selinux/2d-thermography/README.md

2d-thermography
===============

Aquire points or render a 2d-thermography image  using a MLX90614 IR thermometer

This project is mainly going to be a proof of concept :

The main purpose is to control smoothly the hardware and aquire
points as fast as possible throw a serial line. Image rendering
will be done by octave.

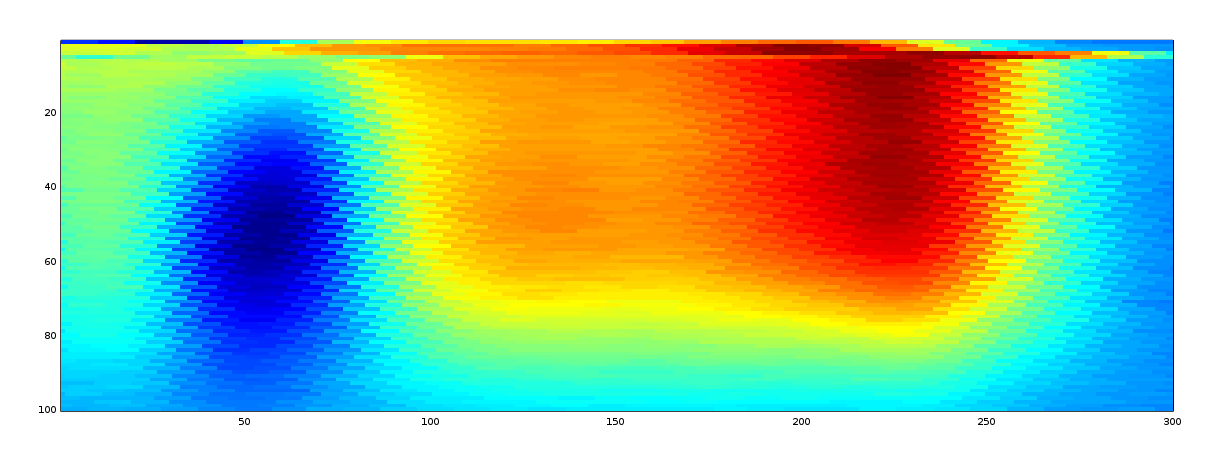
[picture p1: media/source_mesure.png]


    scan duration 10min
 * [video exemple 1...](http://youtu.be/MxMDqLkLDO0)\\
 * [video exemple 2...](http://youtu.be/shVt-1LP7H4)

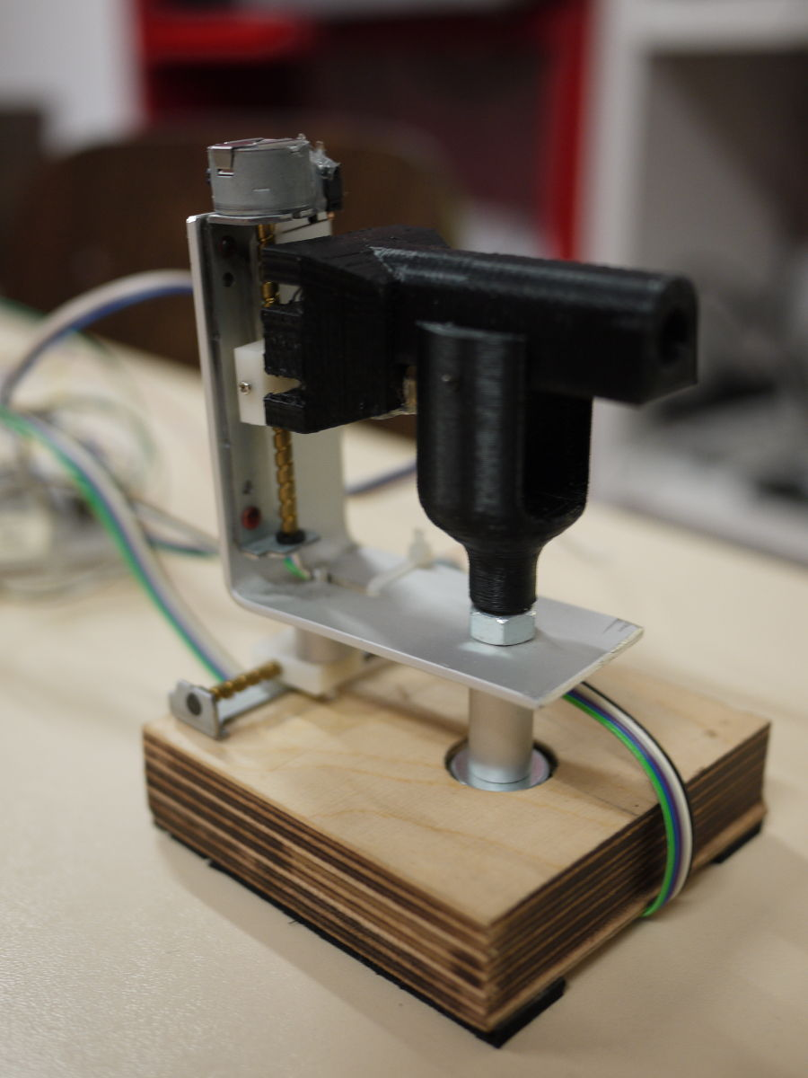
[picture p2: media/2d-thermography-harware_4.jpg]


hardware :
--

    - arduino
    - 2 cd stepper
    - MLX90614ESF-DCI  3V (also available in 5V)
    - a laser pointer
    - ITEAD Dual Step Motor Driver Shield
        (I tryed with Pololu but motors VDD must be > 8V
         to work and cd motor's I use support only 4-6V )
    - 2 mechanic endstop

BOM :
--

* http://shop.boxtec.ch/infrared-thermometer-sensor-medical-mlx90614esf-dci-p-40658.html
* http://www.aliexpress.com/snapshot/6167745304.html
* http://www.aliexpress.com/snapshot/6124275888.html
* http://imall.iteadstudio.com/im120417015.html
