selinux/2d-thermography/docs/links-references.txt

http://bildr.org/2011/02/mlx90614-arduino/

http://wiki.iteadstudio.com/Arduino_Dual_Step_Motor_Driver_Shield
