selinux/2d-thermography/media/2d-thermography-front.jpg

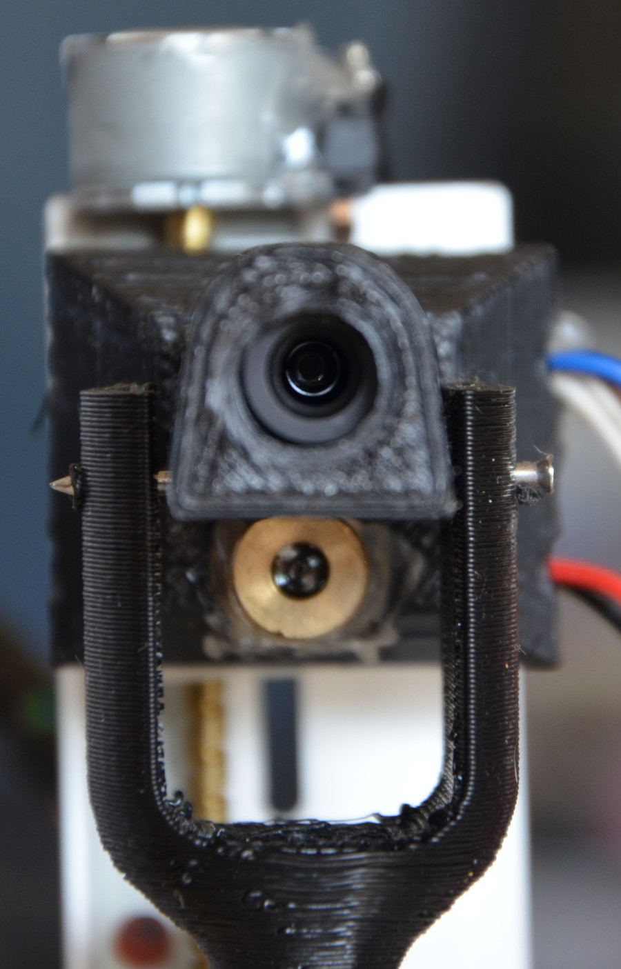
media/2d-thermography-front.jpg
