selinux/2d-thermography/media/2d-thermography-harware_0.jpg

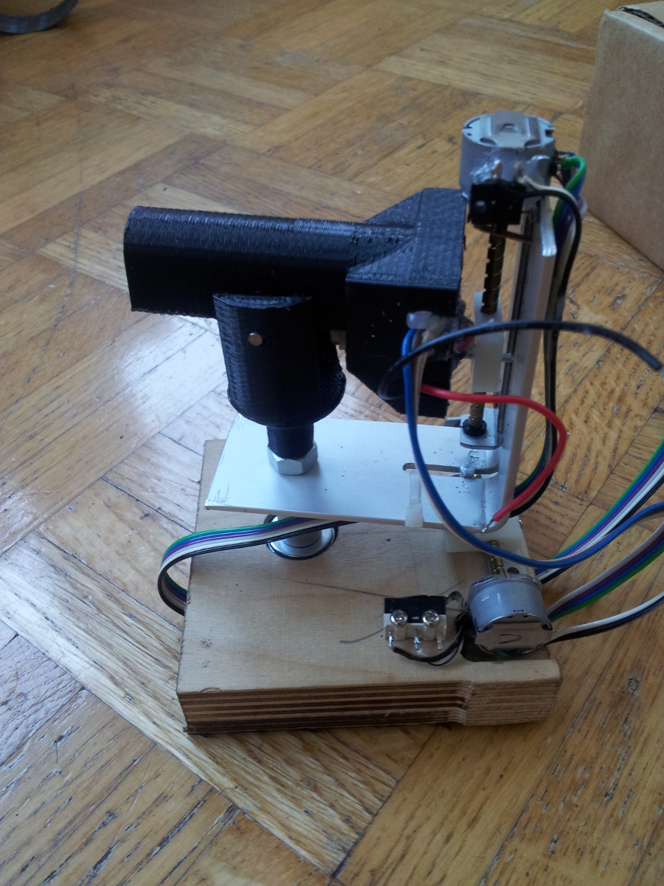
media/2d-thermography-harware_0.jpg
