selinux/2d-thermography/media/2d-thermography-harware_1.jpg

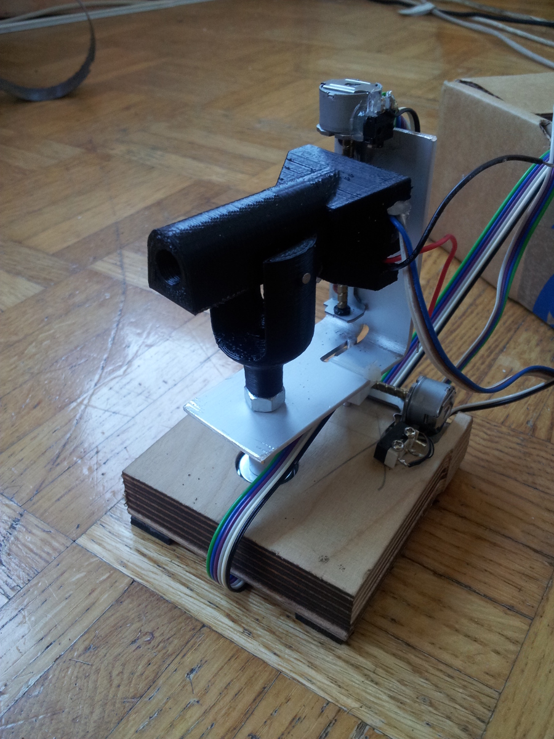
media/2d-thermography-harware_1.jpg
