selinux/2d-thermography/media/2d-thermography-harware_2.jpg

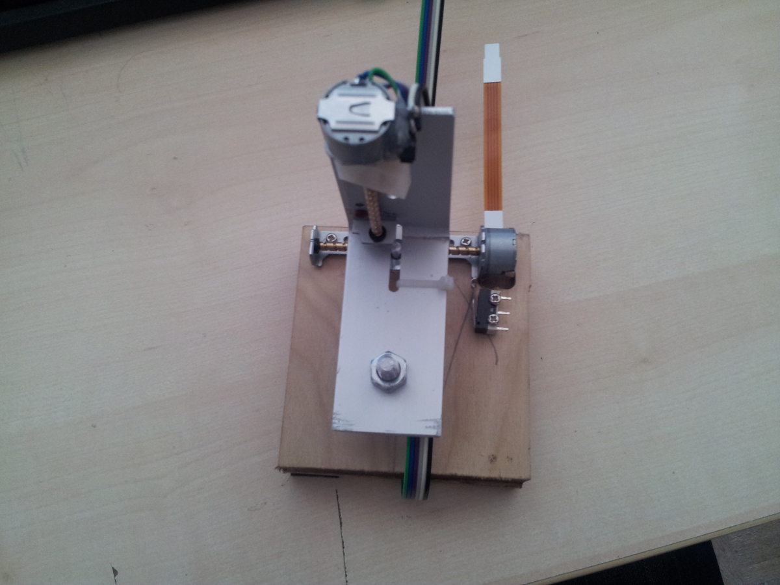
media/2d-thermography-harware_2.jpg
