selinux/2d-thermography/media/2d-thermography-harware_3.jpg

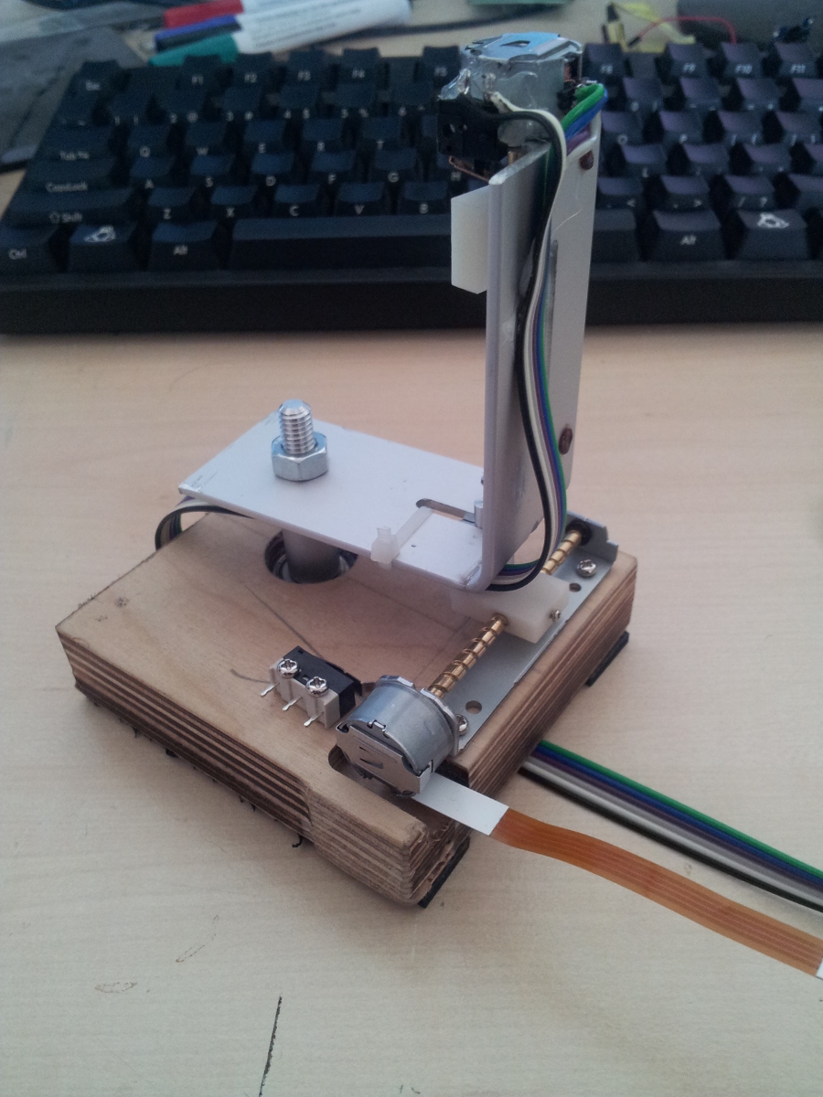
media/2d-thermography-harware_3.jpg
