selinux/2d-thermography/media/2d-thermography-mid.jpg

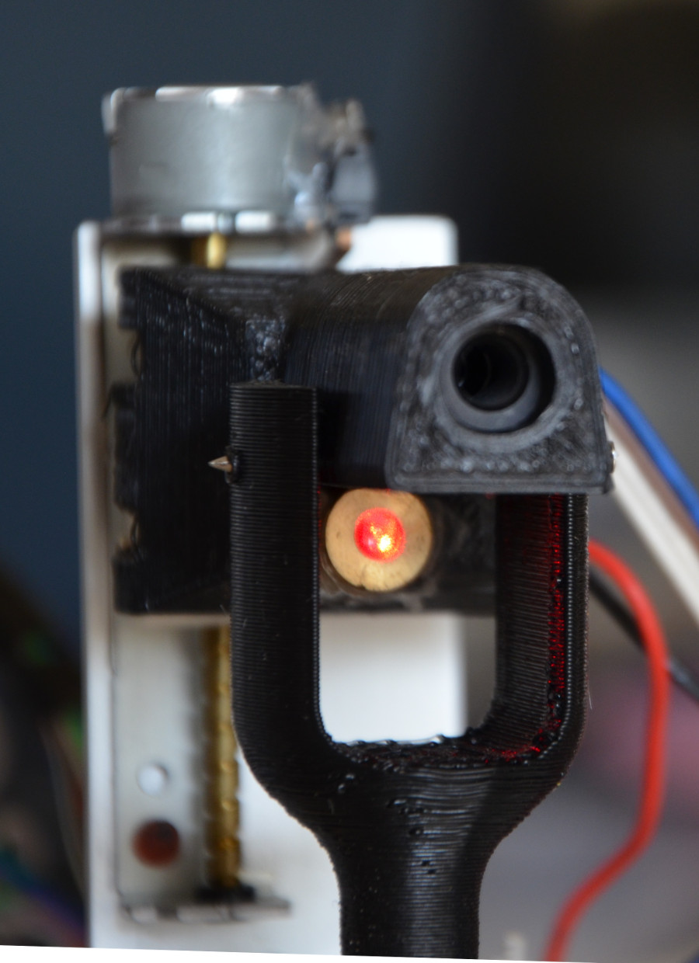
media/2d-thermography-mid.jpg
