selinux/2d-thermography/media/casserolle.png

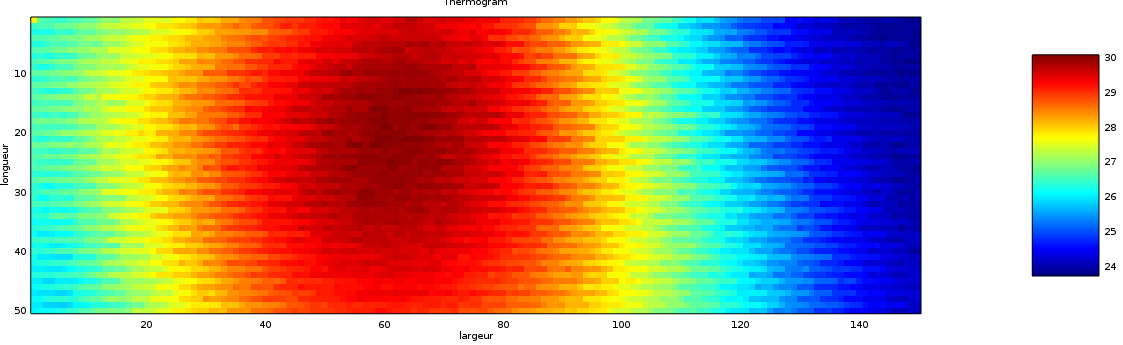
media/casserolle.png
