selinux/2d-thermography/media/casserolle_comp.png

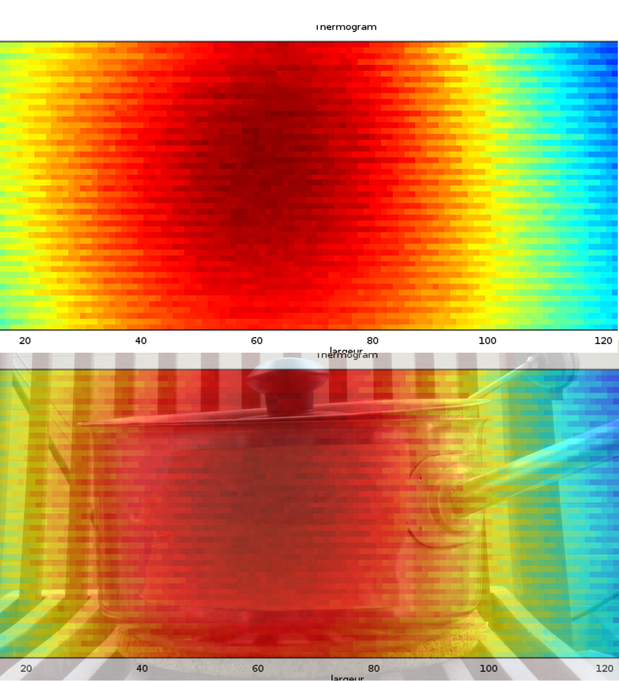
media/casserolle_comp.png
