selinux/2d-thermography/media/delay.png

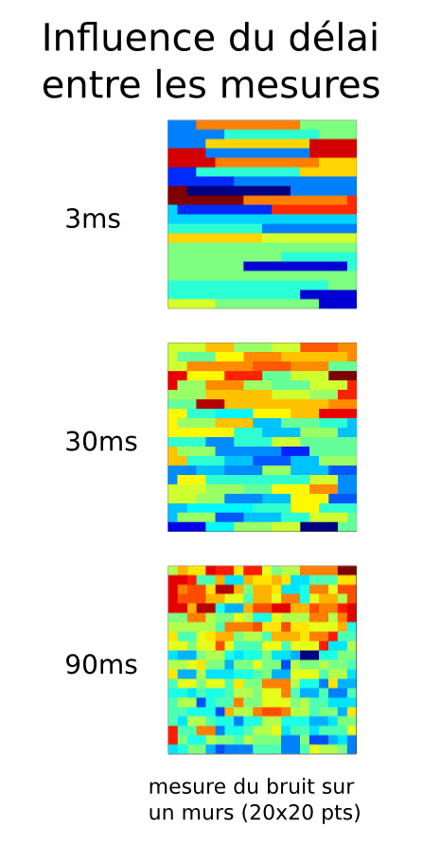
media/delay.png
