selinux/2d-thermography/media/me_site_on_a_chair_(hips).png

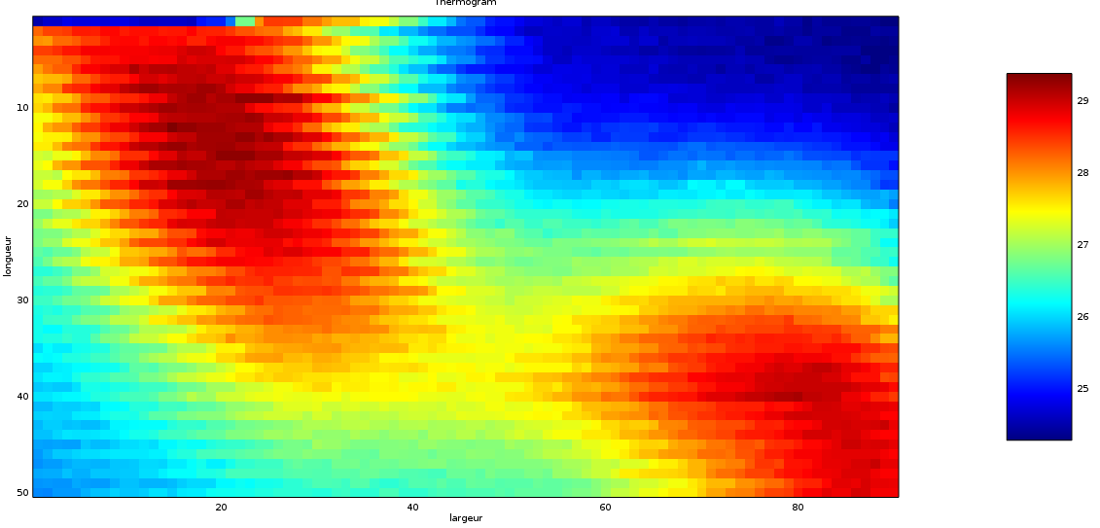
media/me_site_on_a_chair_(hips).png
