selinux/2d-thermography/media/sample-01.png

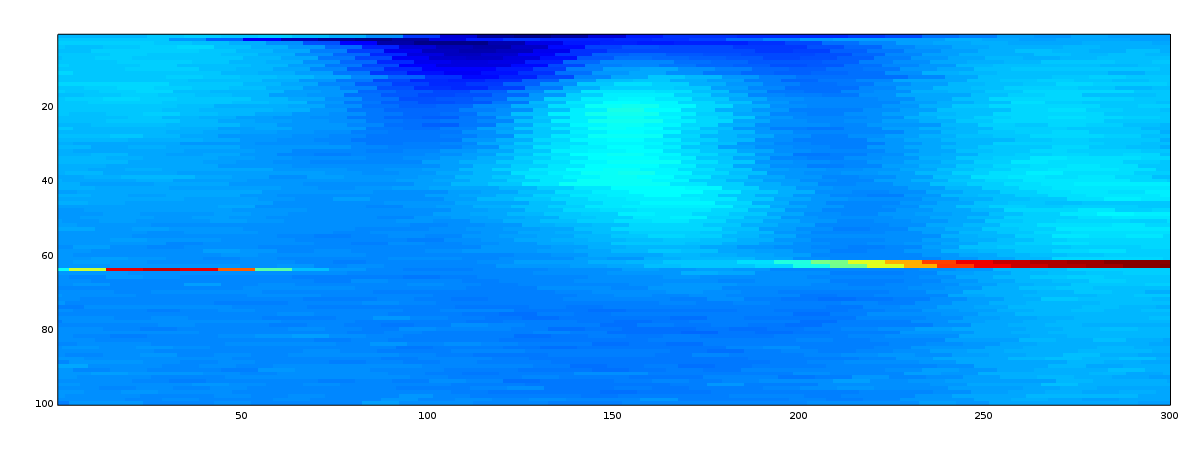
media/sample-01.png
