selinux/2d-thermography/media/sample-02.png

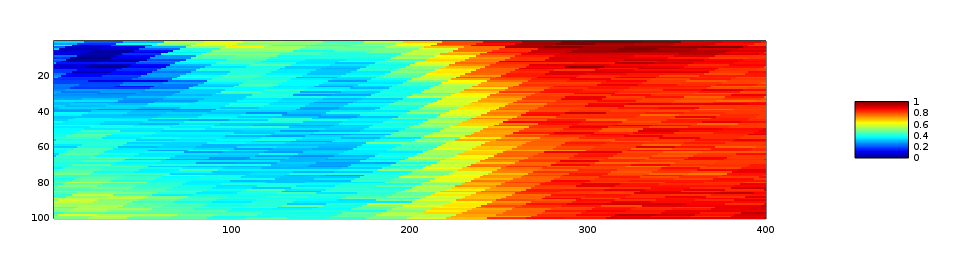
media/sample-02.png
