selinux/2d-thermography/media/sample-03.png

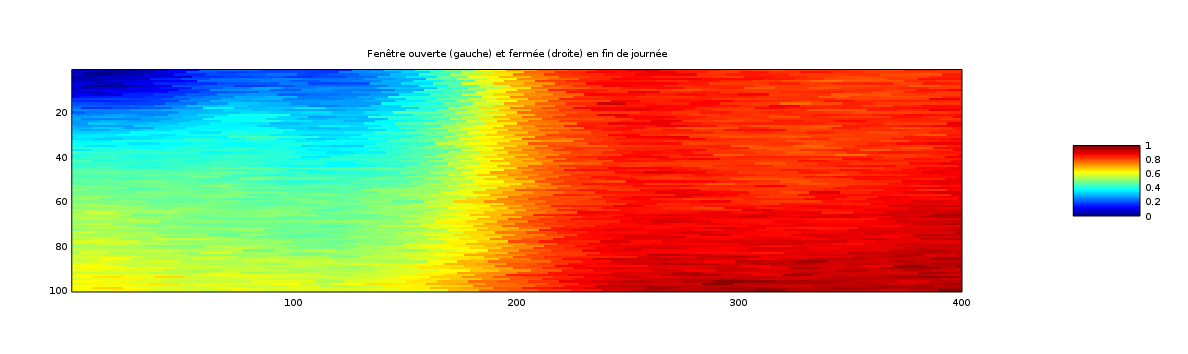
media/sample-03.png
