selinux/2d-thermography/media/sample-04.png

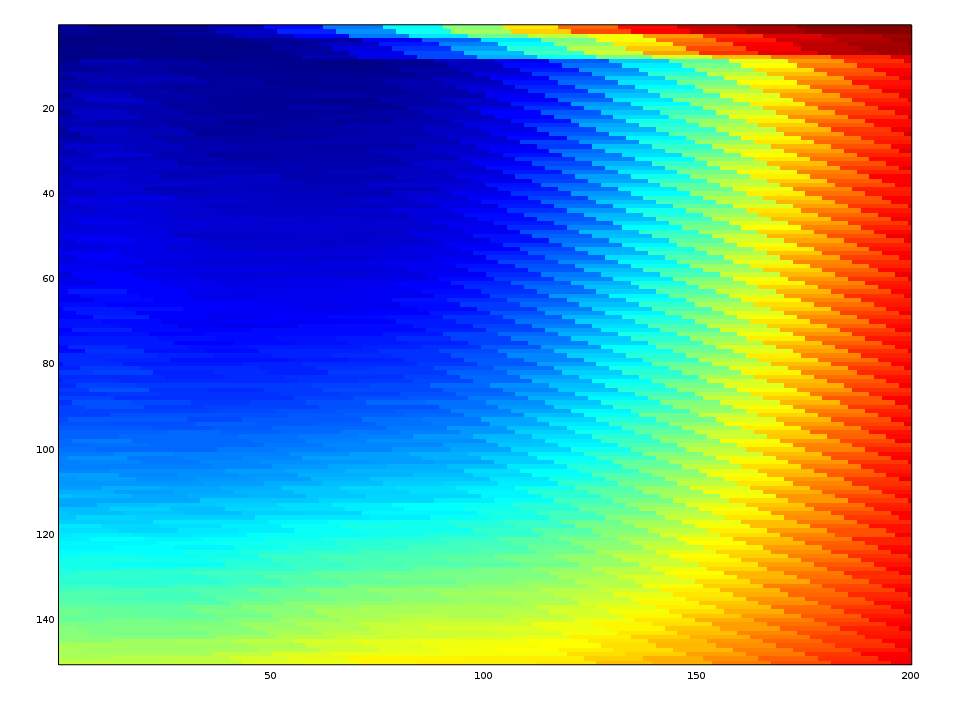
media/sample-04.png
