selinux/2d-thermography/media/sample-05.png

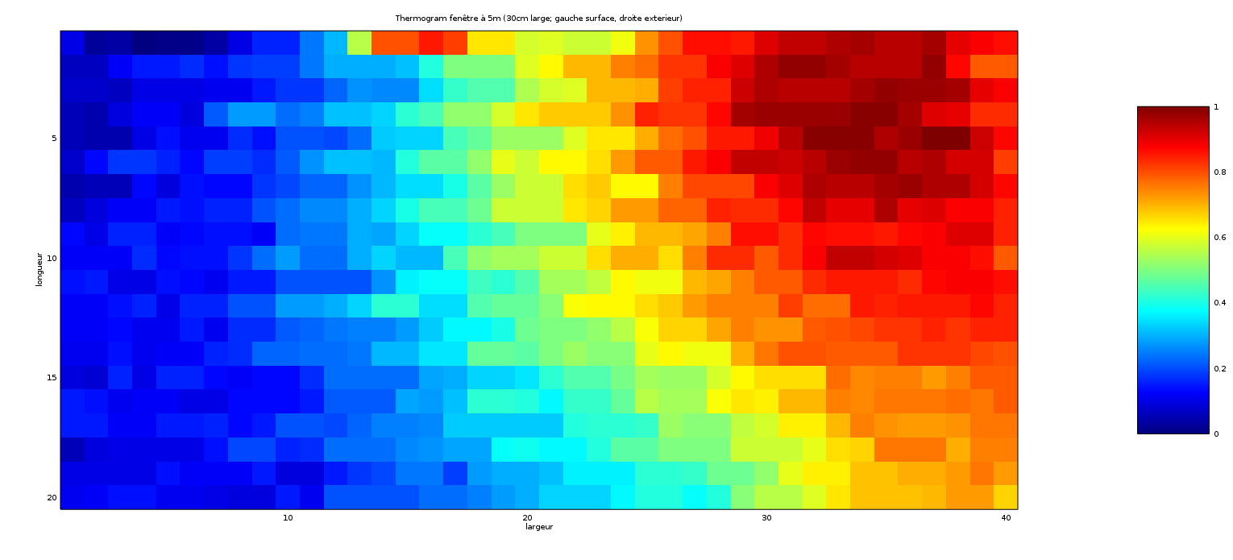
media/sample-05.png
