selinux/2d-thermography/media/sample-06.png

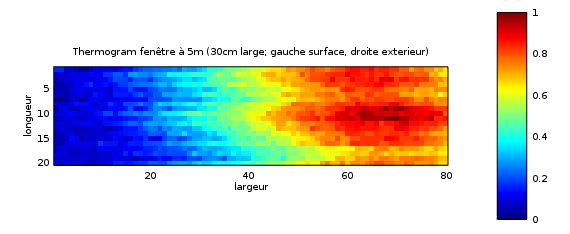
media/sample-06.png
