selinux/2d-thermography/media/sample-07.png

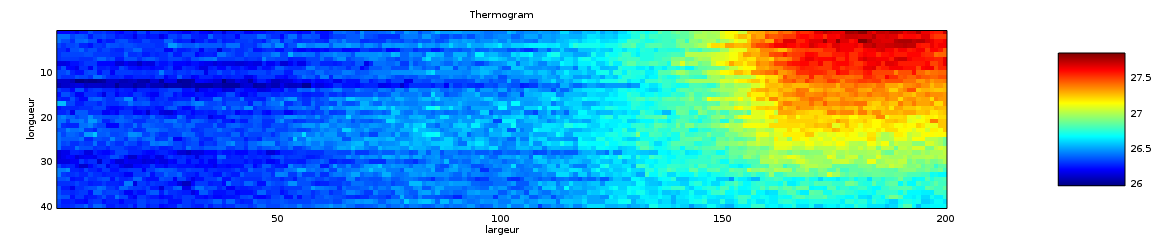
media/sample-07.png
