selinux/2d-thermography/media/sample-08-candle.png

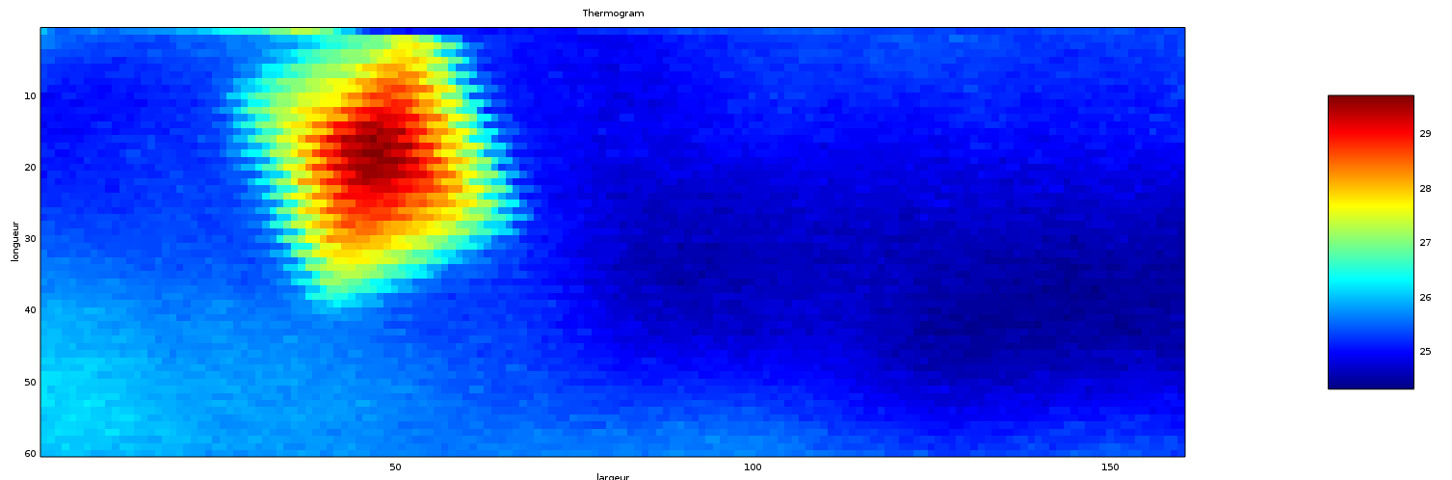
media/sample-08-candle.png
