selinux/2d-thermography/media/sample-09-water_in_a_pot.png

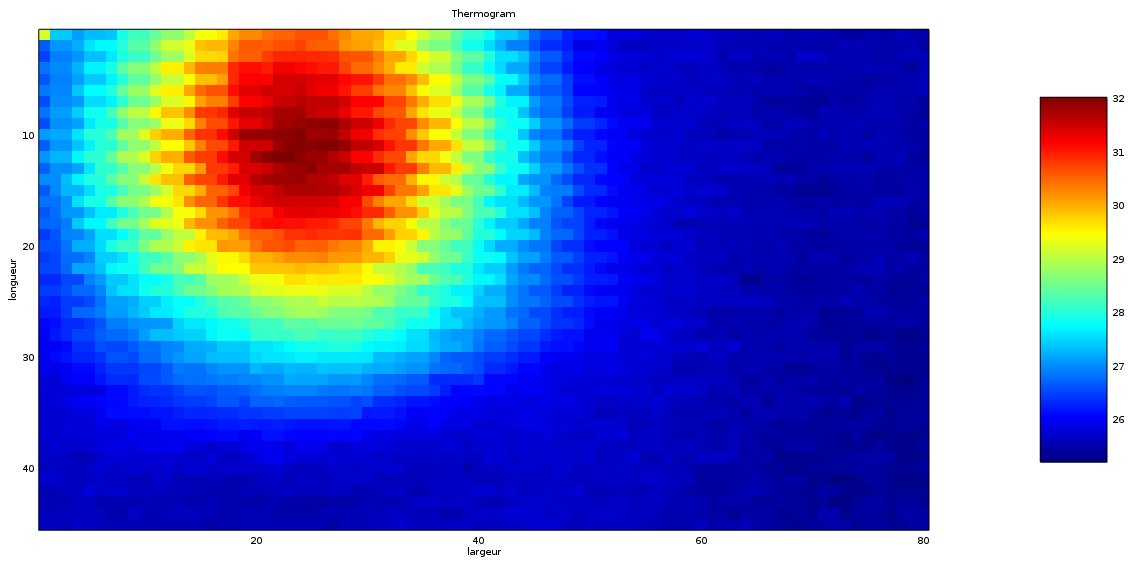
media/sample-09-water_in_a_pot.png
