selinux/2d-thermography/media/sample.png

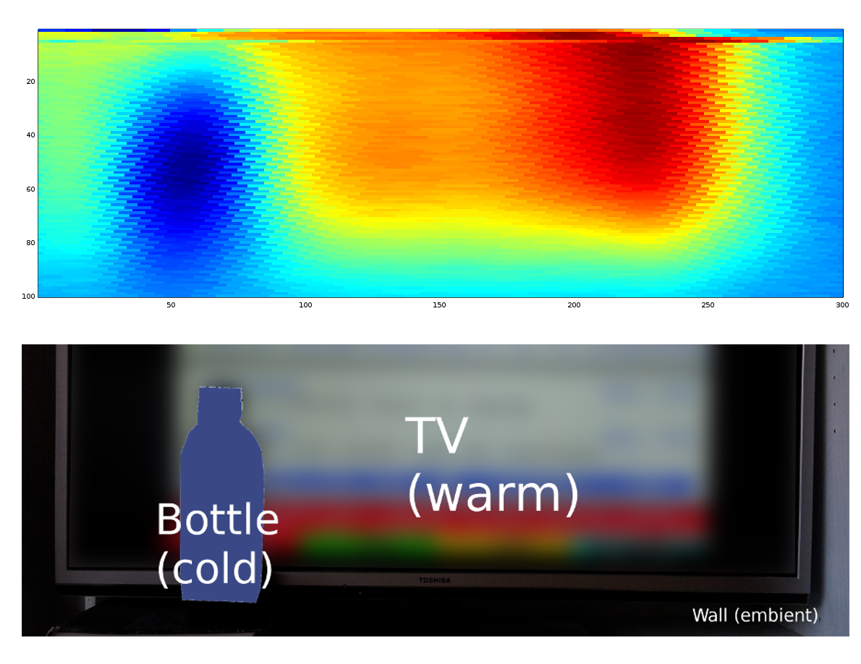
media/sample.png
