selinux/2d-thermography/media/source_sample.png

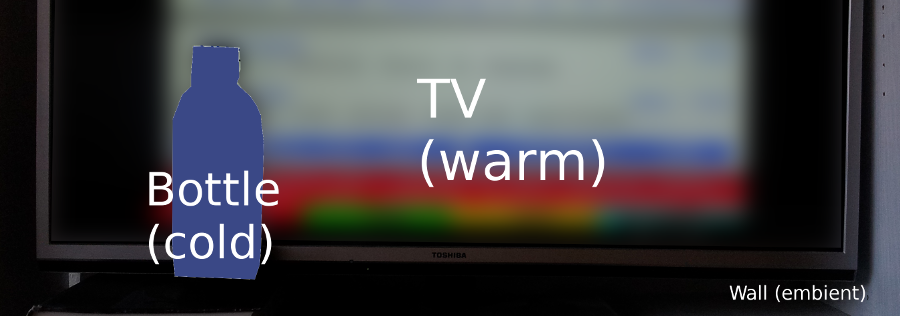
media/source_sample.png
