selinux/2d-thermography/hardware/ensemble.stl

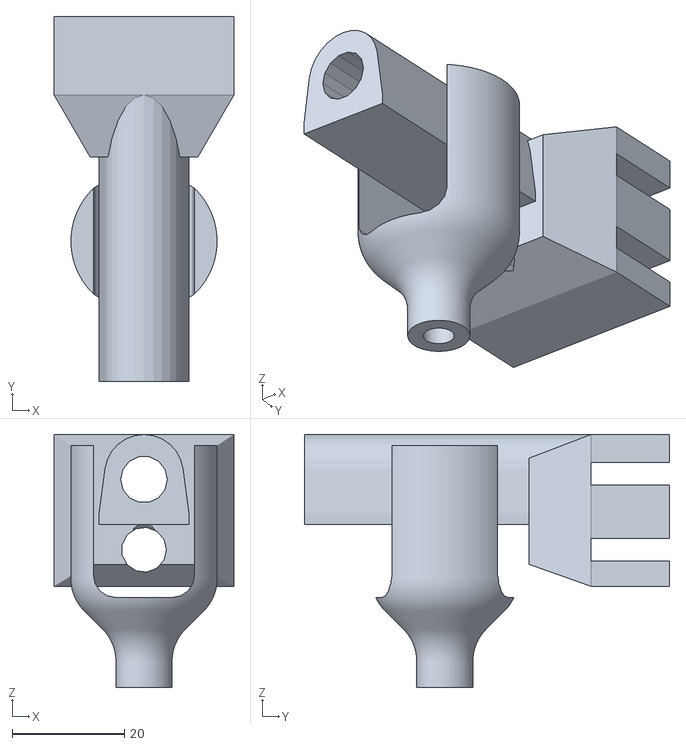
[picture p39: CAD file, 2014-08-30]
hardware/ensemble.stl
32.0 x 65.0 x 45.0
