selinux/2d-thermography/hardware/thermal_camera/fork.stl

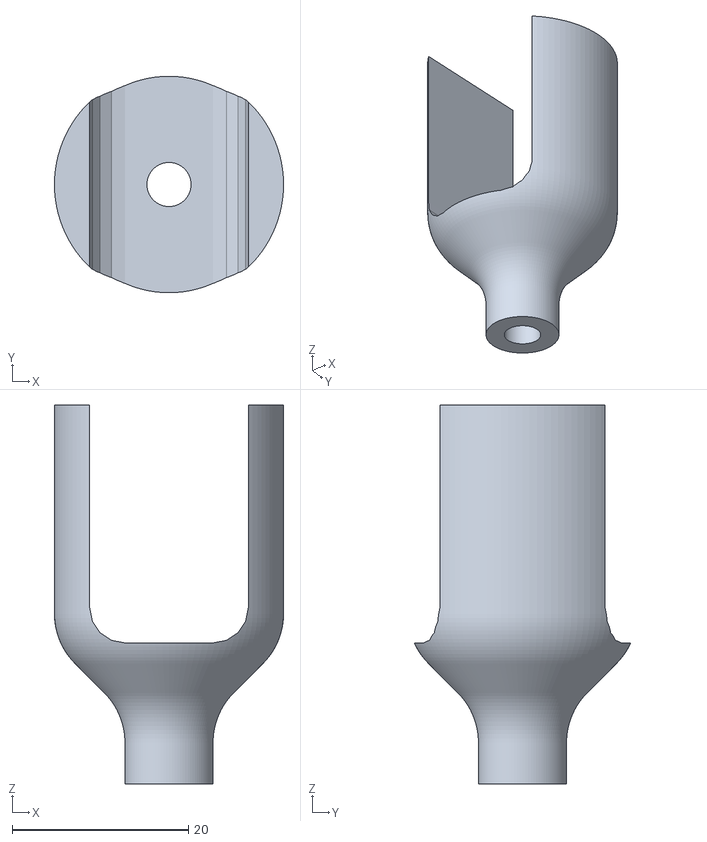
[picture p41: CAD file, 2014-08-25]
hardware/thermal_camera/fork.stl
26.0 x 24.6 x 43.0
