selinux/2d-thermography/hardware/support_thermo.stl

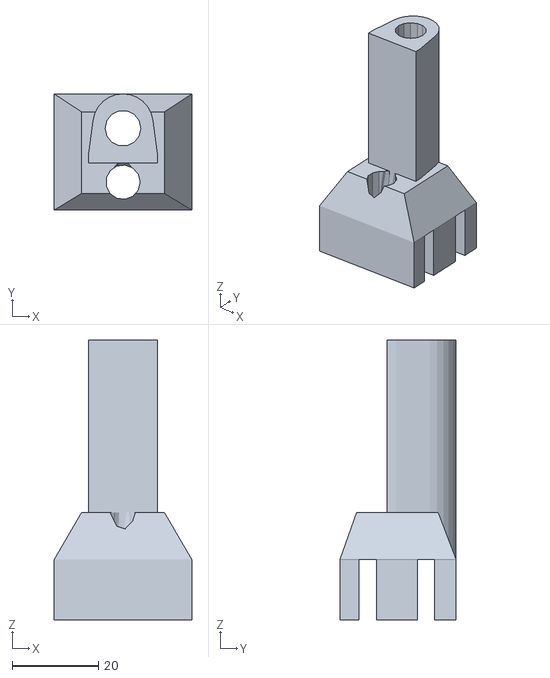
[picture p42: CAD file, 2014-08-30]
hardware/support_thermo.stl
32.0 x 27.0 x 65.0
