selinux/2d-thermography/hardware/thermal_camera/2d-sections/support_therm0.dxf

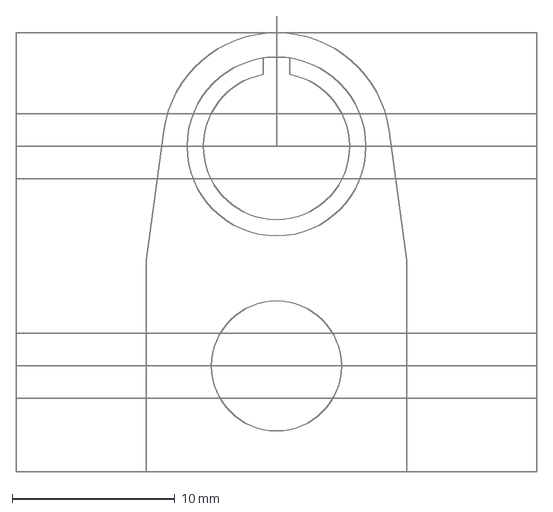
[picture p43: CAD file, 2014-08-27]
hardware/thermal_camera/2d-sections/support_therm0.dxf
32.0 x 28.0 mm
