selinux/2d-thermography/hardware/thermal_camera/ensemble.dxf

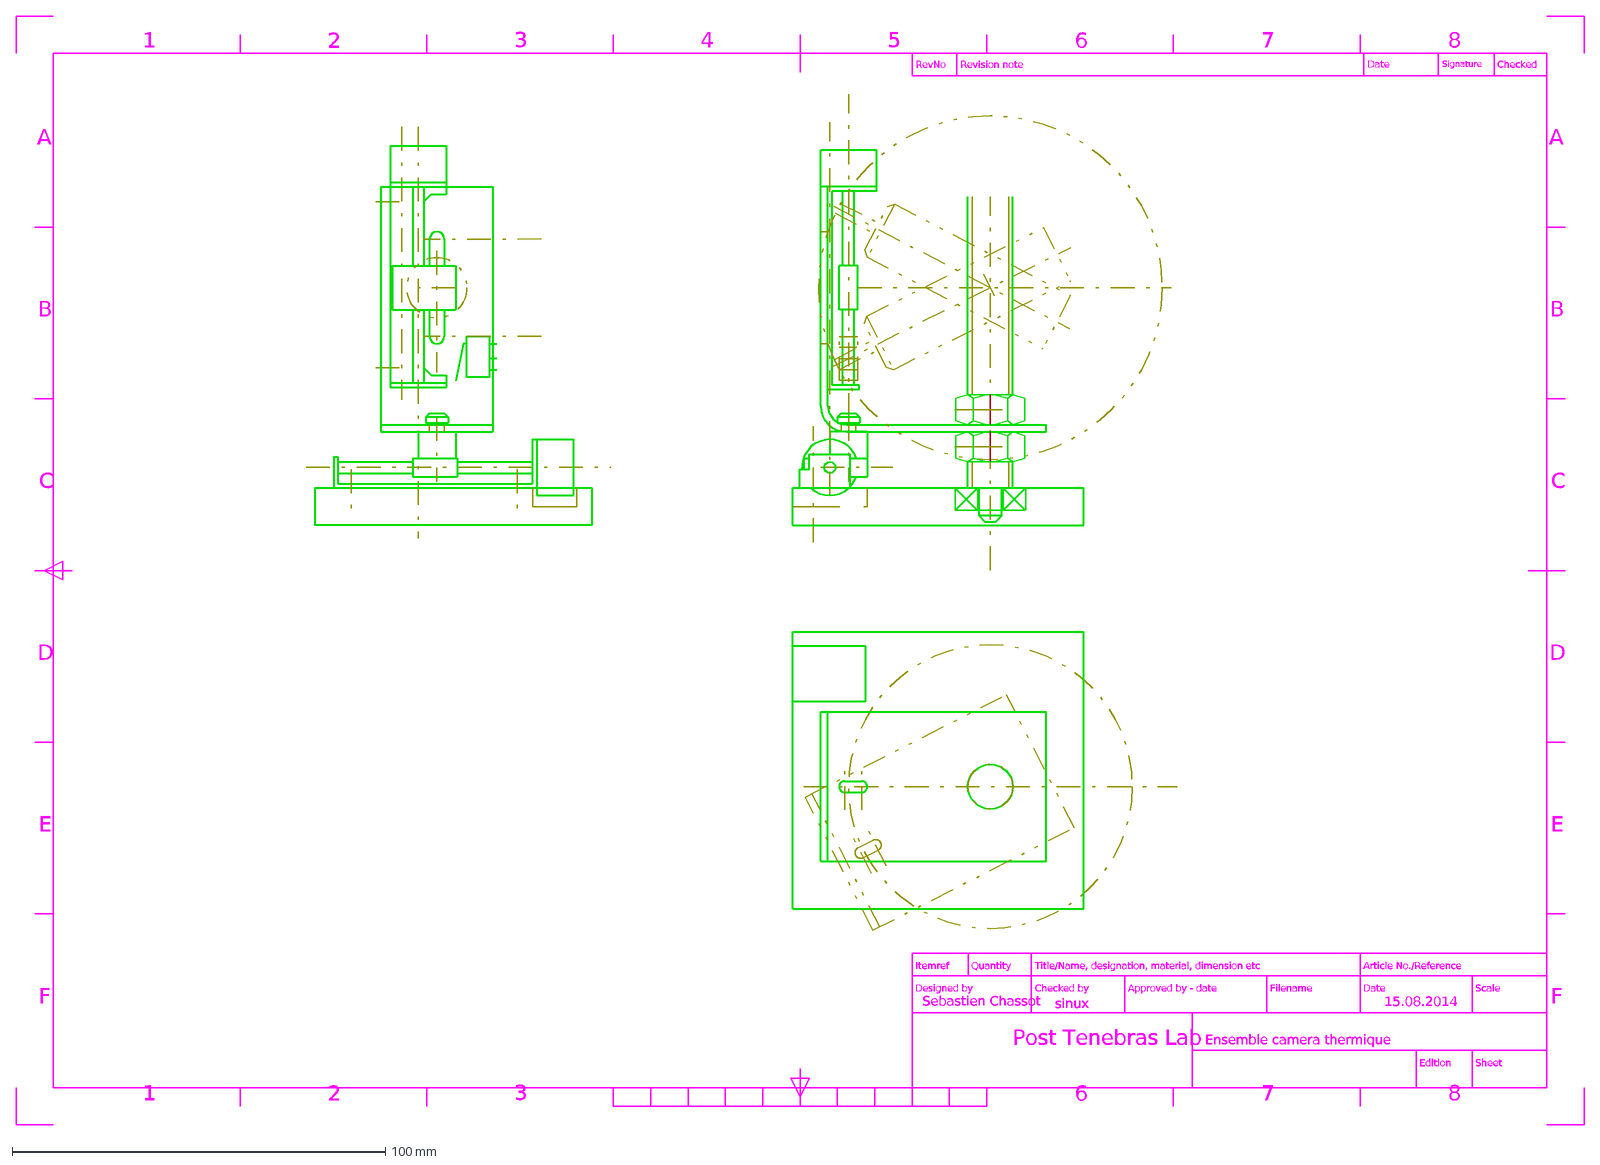
[picture p44: CAD file, 2014-08-25]
hardware/thermal_camera/ensemble.dxf
8
RevNo
Revision note
Signature
Checked
Date
Itemref
Quantity
Designed by
Checked by
Approved by - date
Filename
Title/Name, designation, material, dimension etc
Article No./Reference
Scale
Edition
Sheet
A
B
C
D
E
F
2
1
3
4
5
6
7
Sebastien Chassot
sinux
15.08.2014
Ensemble camera thermique
Post Tenebras Lab
