selinux/2d-thermography/hardware/thermal_camera/2d-sections/support_therm3.dxf

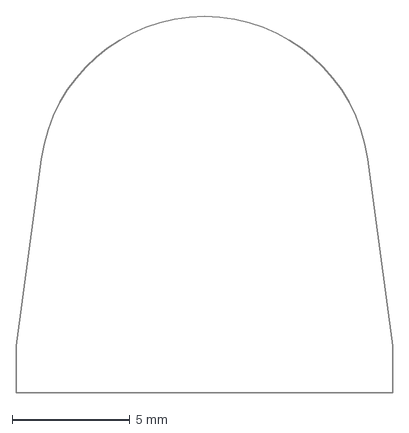
[picture p45: CAD file, 2014-08-27]
hardware/thermal_camera/2d-sections/support_therm3.dxf
16.0 x 16.0 mm
