selinux/2d-thermography/hardware/thermal_camera/2d-sections/support_therm10.dxf

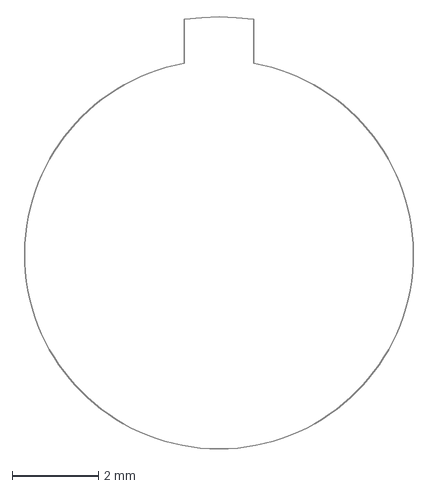
[picture p46: CAD file, 2014-08-27]
hardware/thermal_camera/2d-sections/support_therm10.dxf
9.38 x 10.0 mm
