selinux/2d-thermography/hardware/thermal_camera/2d-sections/support_therm1.dxf

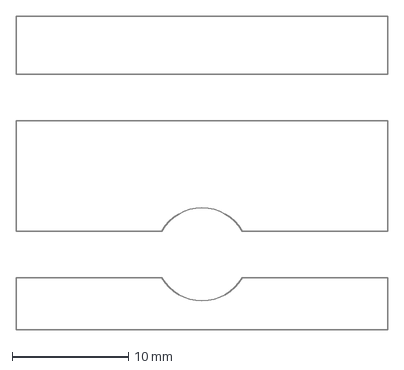
[picture p47: CAD file, 2014-08-27]
hardware/thermal_camera/2d-sections/support_therm1.dxf
32.0 x 27.0 mm
