selinux/2d-thermography/hardware/thermal_camera/2d-sections/support_therm20.dxf

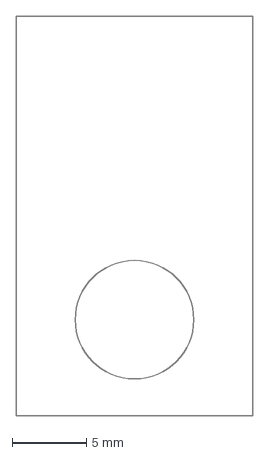
[picture p48: CAD file, 2014-08-27]
hardware/thermal_camera/2d-sections/support_therm20.dxf
16.0 x 27.0 mm
