selinux/2d-thermography/hardware/thermal_camera/2d-sections/fork0.dxf

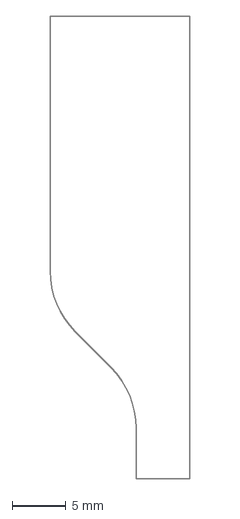
[picture p49: CAD file, 2014-08-25]
hardware/thermal_camera/2d-sections/fork0.dxf
13.0 x 43.0 mm
