selinux/2d-thermography/hardware/thermal_camera/2d-sections/fork.dxf

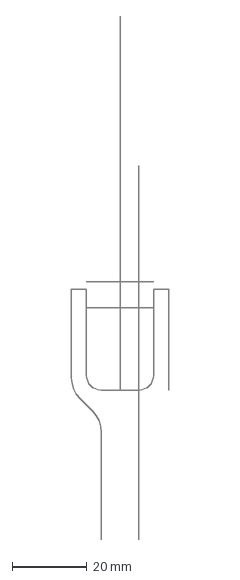
[picture p50: CAD file, 2014-08-25]
hardware/thermal_camera/2d-sections/fork.dxf
26.0 x 140.0 mm
