selinux/2d-thermography/hardware/thermal_camera/2d-sections/fork1.dxf

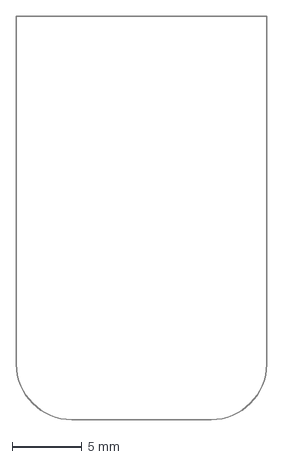
[picture p51: CAD file, 2014-08-25]
hardware/thermal_camera/2d-sections/fork1.dxf
18.0 x 29.0 mm
