selinux/2d-thermography/media/debug_Cte-10x10.png

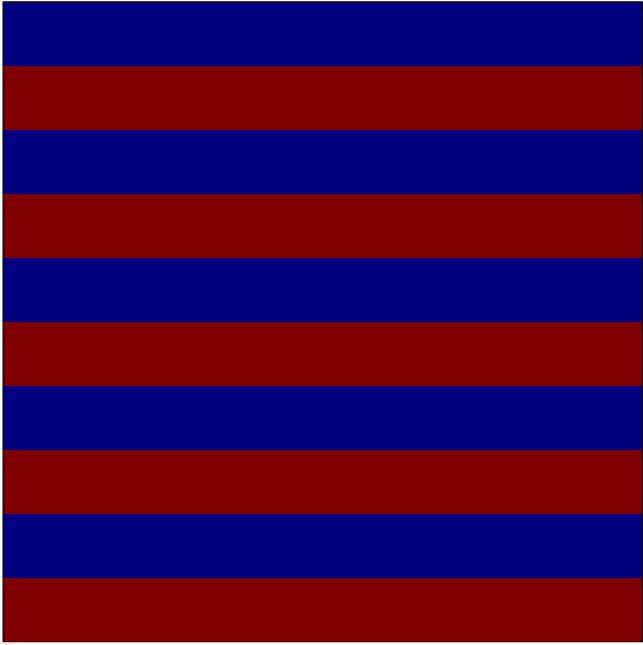
media/debug_Cte-10x10.png
