selinux/2d-thermography/hardware/thermal_camera/ensemble.pdf

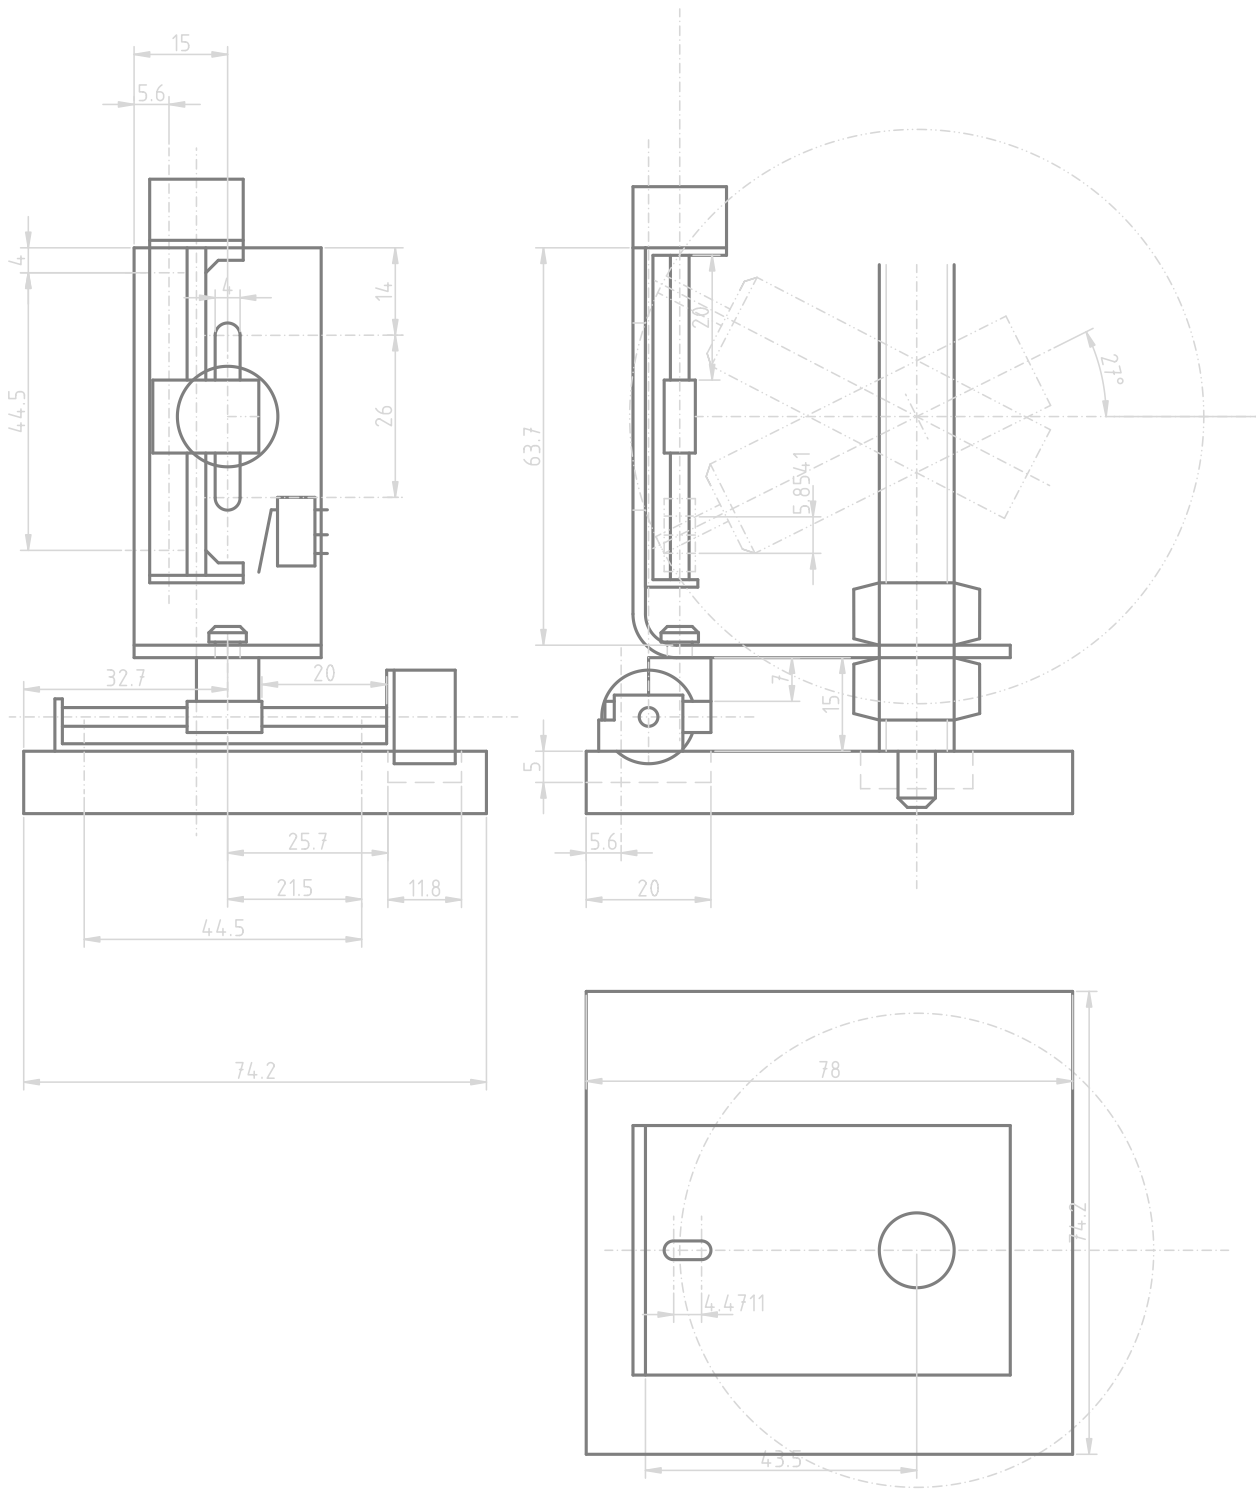
[picture p53: page 1]
