selinux/2d-thermography/(list of files, drawings)

Other design files:
docs/schema.fzz
