selinux/2d-thermography/(commit log)

2014-08-27 first draft stepper motion
2014-08-27 improved arduino sketch
2014-08-27 modified hardware (support therm)
    [ensemble.scad, fork.scad, support_therm0.dxf, support_therm1.dxf, support_therm10.dxf, support_therm2.dxf, support_therm20.dxf, support_therm3.dxf]
2014-08-28 modifié support capteur
    [ensemble.scad, support_thermo.scad]
2014-08-28 added fritzing schema
    [schema.fzz]
2014-08-30 change pics
    [ensemble.dxf, ensemble.scad, ensemble.stl, fork.dxf, fork.scad, fork.stl, fork0.dxf, fork1.dxf]
2014-08-31 corrigé microsteppin et ENDSTOP input
    [thermal_cam.ino]
2014-08-31 first draft reading arduino serial communication from octave
2014-08-31 changed serial.print arduino side and minor changes octave side
2014-09-02 sample code with 40x20 reading points. Octave start code and parse values
2014-09-02 changé methode de lecture avec octave
2014-09-03 corrigé toggle direction dans boucle for
    [cartesian_only.ino]
2014-09-03 first result arduino mesure -> octave matrice and render image(mesures)
2014-09-04 changé difinition sens des moteurs
2014-09-04 commancé optimisation communication seriel octave->arduino->octave
2014-09-04 arduino en attente de coordonnées pour démarrer le scan
2014-09-05 ajouté laser et retour pos départ après scan
2014-09-06 changé lecture alternée par lecture de gauche à droite (retour à vide)
2014-09-06 added media pics and samples
2014-09-06 added more samples
2014-09-09 mis à jour hardware final release
    [ensemble.stl, support_thermo.stl]
2014-09-09 mis à jour docs et commanté code
    [schema.fzz]
2014-09-09 changement mineur doc
    [schema.fzz]
2014-09-10 commenté debug lecture multiple en fin de ligne
2014-09-10 ajouté media, présentation et sample
